vGsteiger/caos_gruppe_144/README.md

# 144 - Arduino Project

144, or the number of Leds in our 3-Dimensional Led display, is a project for the Computer Archidecture and Operating System lecture at the University of Basel. 

*Last major edit: 15. January, 2020*

Current version: v1.0

### Team members: 
* Viktor Gsteiger
* Joey Zgraggen
* Moritz Würth
