vGsteiger/caos_gruppe_144/doc/Presentation/Presentation144.pptx

## CAOS Projekt Präsentation RGB-LED Quader 144

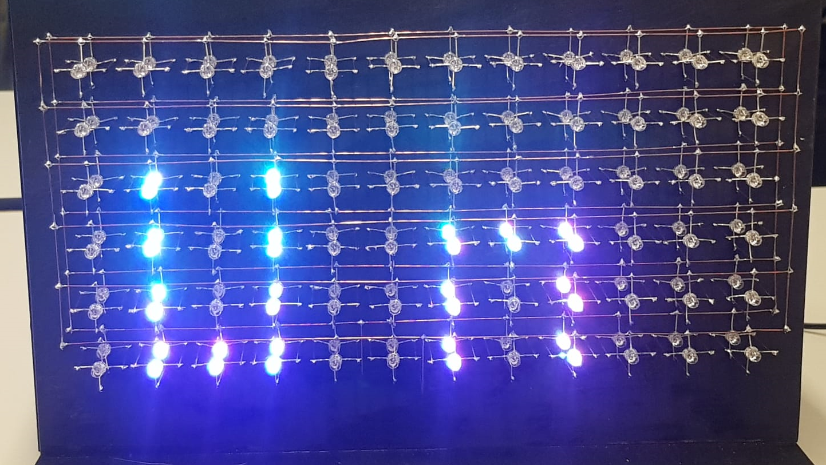
[picture p6: figure]

- Joey Zgraggen
- Moritz Würth
- Viktor Gsteiger

## Einführung

- Grundidee : RGB-LED Cube
- Eigene Effekte
- Selbst geschriebener Code
- Einfach erweiterbar

## Probleme

- Angehensweise -> Arduino Forum / Conrad
- Transistoren verwenden?
- RGB -> viele Pins -> viel Lötarbeit
- Eine Platine
- Kritische Stellen -> Isolierband

## Hintergrund

- Beispielprojekt Internet (8x8x8 Cube)
- Lösung im Code
- Box-Design
- Nicht nur Effekte

## Implementation

- Struktur
  - Main, Logik, Features
- Prototyp
- Kommunikation Schieberegister
  - Effekte
  - Einfache Schnittstelle
- Features

## Ergebnisse

- Materialtest
- Schablone
- Zwei Platinen
  - Mehr Spielraum
  - Paralleles Arbeiten
- Holzgestell
- Plexiglas Haube (durchsichtig)

## Lessons Learned

- Breadboard guter Anfang
- Prototyp hilfreich
- Gute Organisation wichtig
- Tests
- Gitproject

## Vielen Dank für eure Aufmerksamkeit
