vGsteiger/caos_gruppe_144/doc/CAOSProject (2).jpg

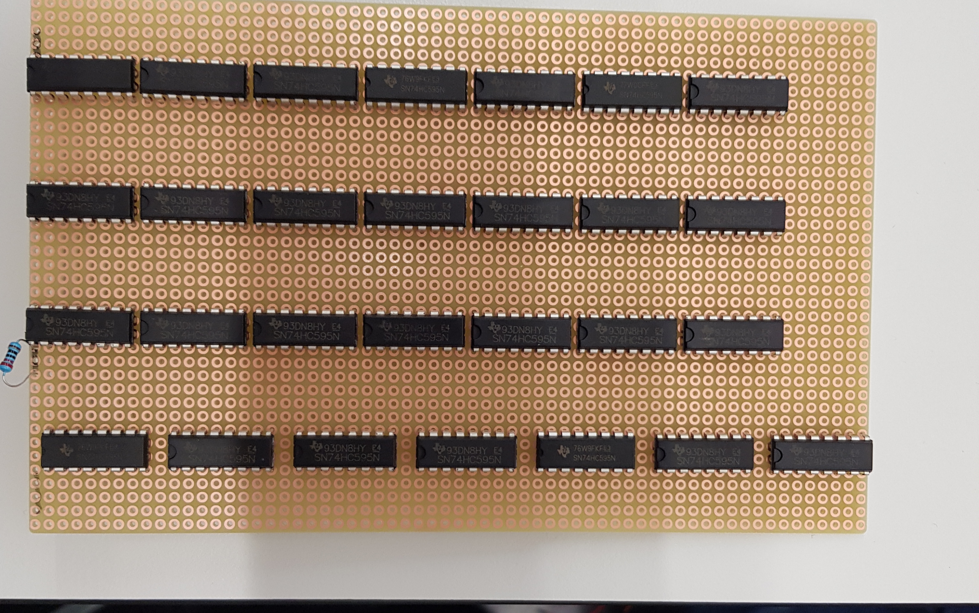
doc/CAOSProject (2).jpg
