vGsteiger/caos_gruppe_144/doc/CAOSProject (4).jpg

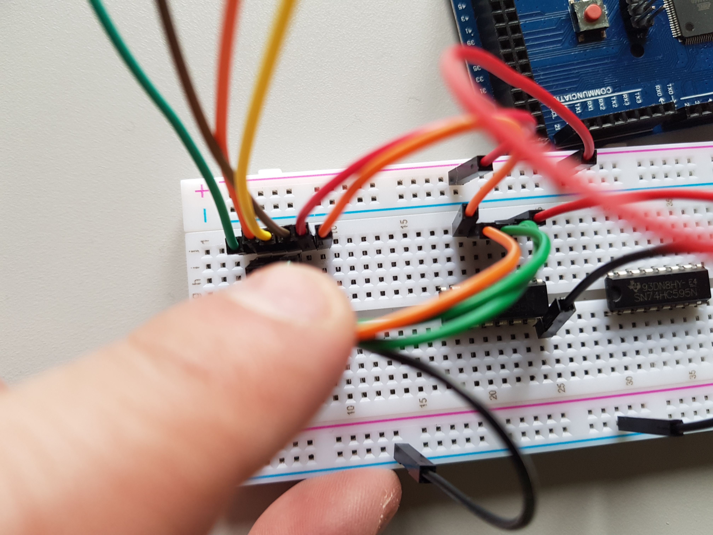
doc/CAOSProject (4).jpg
