vGsteiger/caos_gruppe_144/doc/CAOSProject (6).jpg

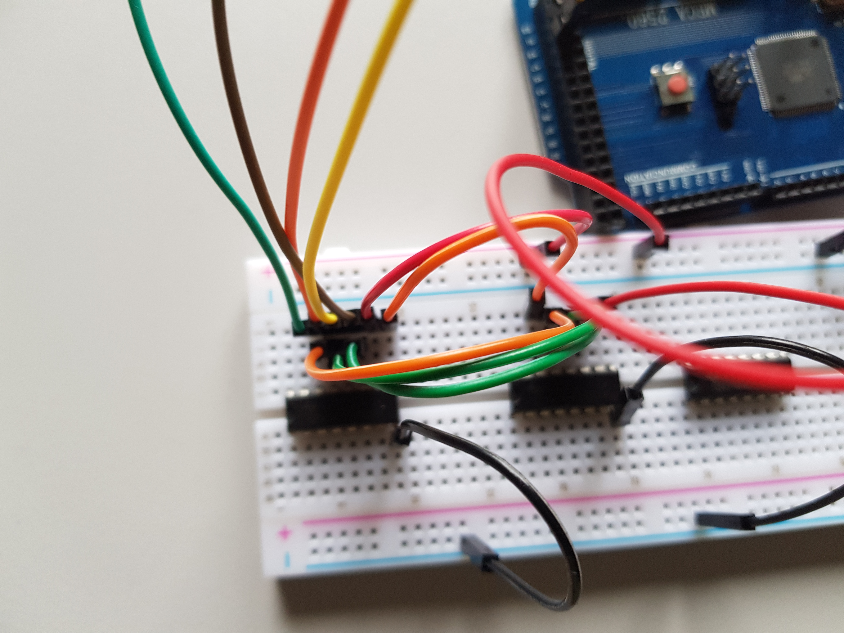
doc/CAOSProject (6).jpg
