vGsteiger/caos_gruppe_144/(threads)

Thread 11 (2019-12-07):

Add logic for a motion sensor

vGsteiger, 2019-12-07:
It would be nice if the display would start-up if someone walked by.

vGsteiger, 2019-12-18:
It doesn't make sense with the remote as steering device.

Closed 2019-12-18.

Thread 14 (2019-12-07):

Any other animation ideas?

vGsteiger, 2019-12-07:
Leave a comment with ideas so we can collect some ideas.

So far I have:

- [x] GOL
- [x] Firework
- [x] Letters
- [x] Weather animations
- [ ] Waves

Do you have any other ideas?

joeyzgraggen, 2019-12-08:
Here some more ideas:

- Time
- Stars (which go from left to right)
- Random Pattern (randomly lighting up LED's with random Color. Might look ugly :-) )
- Temperature

vGsteiger, 2019-12-09:
@joeyzgraggen You can just make a tick off list, so we can easily keep track :).

And the temperature is already implemented in the weather "animations".

What do you mean by stars?

Thanks for the great feedback!

joeyzgraggen, 2019-12-09:
That's great that the temperature is already implemented. I didn't see it when i looked over the code.

I think i am going to explain the "stars" effect in our next meeting.

vGsteiger, 2019-12-09:
@joeyzgraggen still, if you change your bullet points to a tick-off list it would make it easier to keep track of what is already done ;-)

Closed 2019-12-18.

Thread 15 (2019-12-11):

Time

vGsteiger, 2019-12-11:
A clock which displays the current time.

vGsteiger, 2019-12-18:
https://create.arduino.cc/projecthub/electropeak/interfacing-ds1307-rtc-module-with-arduino-make-a-reminder-08cb61

Closed 2019-12-21.

Thread 21 (2019-12-18):

IR Remote

vGsteiger, 2019-12-18:
Add the logic for an infrared remote to steer some games.

vGsteiger, 2019-12-18:
http://www.circuitbasics.com/arduino-ir-remote-receiver-tutorial/

Closed 2019-12-29.
