vGsteiger/caos_gruppe_144/src/main/setLedOnCalculations.ino

void setLedOn(int x, int y, int red, int green, int blue, int layer)
{
  x = constrain (x,    0, 11);      // x can only be between 0 and 11 as we have 12 leds length
  y = constrain (y, 0, 5);          // y can only be between 0 and 5 as we have 6 height
  red = constrain (red,    0, 1);   // Red can either be 1 or 0
  green = constrain (green,  0, 1); // Green can either be 1 or 0
  blue = constrain (blue,   0, 1);  // Blue can either be 1 or 0
  layer = 0;     // layer can only be 0 or 1 as we only have two layers

  int whichByte = int(((x * 3 + 36 * y) + 1) / 8); // Calculate which byte be have to change
  int whichBit = ((((y * 36 + x * 3) + 1) % 8) - 1); //  Calculate which bit in that byte we have to set on
  if (whichBit == -1) {
    whichBit = 7;
    whichByte--;
  }
  //Serial.println("Currently in byte:");
  //Serial.println(whichByte);

  //Serial.println("Currently in bit:");
  //Serial.println(whichBit);
  /**
     Choses between the two available layers of our LED RGB Cubic.
  */
  if (whichBit == 7) { // The mistake with the colors must be here!
    bitWrite(anodes0[whichByte], whichBit, blue);
    bitWrite(anodes0[whichByte + 1], 0, green);
    bitWrite(anodes0[whichByte + 1], 1, red);
  } else if (whichBit == 6) {
    bitWrite(anodes0[whichByte], whichBit, blue);
    bitWrite(anodes0[whichByte], whichBit + 1, green);
    bitWrite(anodes0[whichByte + 1], 0, red);
  } else {
    bitWrite(anodes0[whichByte], whichBit, blue);
    bitWrite(anodes0[whichByte], whichBit + 1, green);
    bitWrite(anodes0[whichByte], whichBit + 2, red);
  }
}
