vGsteiger/caos_gruppe_144/(commit log)

2019-11-23 Added first version of the arduino code.
    Untested first version with basic logic to test and work with our setup.
2019-11-27 Further changes to the formula
    Finally got a working version of the led calculation formula done
2019-11-28 Implemented button
    Simple method and variables for a button to change between effects.
2019-12-07 Implemented large parts of Alphabet and Temperature
    Implemented the sensor logic to read temperature and humidity, added large parts of the alphabet to alphabet and restructured some code.
2019-12-12 Fixed some stupid mistakes
    [firework.ino, setLedOnCalculations.ino]
2019-12-12 Worked on star
    primary functionality is in place, currently working on the star meeting and explosion.
2019-12-18 Minor cleanup on stars to resolve compile errors.
    [stars.ino]
2019-12-19 Prototyping
    Tested the new multiplexer, didn't work
    [testEffect.ino]
2019-12-21 Commented and corrected most parts of the code
    Refreshed the comments in the code and applied some subtle changes.
    [alphabet.ino, bitShifterLogic.ino, clock.ino, firework.ino, gol.ino, main.ino, stars.ino, temperatureEffects.ino]
2019-12-22 Auto-formatted all classes and played around with IR Sensor
2019-12-22 Changed the IR Modus from interrupt to polling
2019-12-29 Implemented the logic of the IR sensor
2020-01-08 Prototyping and fixing stuff
    [alphabet.ino, bitShifterLogic.ino, firework.ino, gol.ino, main.ino, setLedOnCalculations.ino, stars.ino, testEffect.ino]
2020-01-08 Fixed the set led on
    [setLedOnCalculations.ino, testEffect.ino]
2020-01-08 Fixed some ledoncalcs
2020-01-08 Added a Exel File for an overview of the pins of our LED RGB Cubic
    [LED Quader.ods]
2020-01-08 Updated the Excel sheet
    [LED Quader.ods, LED Quader.xlsx]
2020-01-09 Fixed the error with out setLedOn
    [LED Quader.xlsx]
2020-01-10 Major revamp of clock, testing with IR Sensor and other small changes
2020-01-11 Fixed Alphabet, worked on snake
    [Snake.ino, alphabet.ino, bitShifterLogic.ino, clock.ino, firework.ino, gol.ino, main.ino, setLedOnCalculations.ino]
2020-01-12 added a function to decrement the timer value of the stars so they start moving
2020-01-12 timer now decrements every second of every single star, i didn't. The wrong timer was decremented.
    [stars.ino]
2020-01-12 removed bracket which was not necessary
2020-01-13 deleted arduinolanguage file because we dont need it anymore
2020-01-15 Updated testEffect and fixed star effect
    [stars.ino, testEffect.ino]
2020-01-19 switched two slides (2 and 3)
